mmss66661/crtc/README.md

# CRTC_CAR_DEMO

基于 **STM32F103C8T6** 的 PS2 手柄遥控小车，参加**重庆大学机器人训练大赛 CRTC2026**。
HAL 库 + CMake/Ninja 构建，C/C++ 混合编程。

PS2 手柄经软件模拟 SPI 时序读入摇杆与按键，主循环按麦轮逆运动学解算后驱动 4 路电机 PWM，实现前进、后退、左右横移与原地旋转；手柄「×」键切换 PB9 上的舵机角度。

---

## 演示视频

两段实拍记录：PS2 手柄遥控下底盘的起动、转向与停止。均为 **1920×1080 / 60 fps / H.264 + AAC**，满足手册 4.5 对清晰度的要求。

### 演示一：手柄遥控整机运动

<video src="docs/media/chassis-remote-01.mp4" controls width="720"></video>

> [`docs/media/chassis-remote-01.mp4`](docs/media/chassis-remote-01.mp4) —— 4.48 s / 12.2 MB

### 演示二：手柄遥控连续行驶

<video src="docs/media/chassis-remote-02.mp4" controls width="720"></video>

> [`docs/media/chassis-remote-02.mp4`](docs/media/chassis-remote-02.mp4) —— 10.45 s / 26.8 MB

> GitHub 会过滤 README 中的 `<video>` 标签，网页端请点击上方链接播放；VS Code / Typora 等本地预览可内联播放。

四轮电机开环 PWM 的单独演示见 [`docs/media/chassis-motion.mp4`](docs/media/chassis-motion.mp4)，硬件设计稿与实物见 [`docs/硬件开发记录.md`](docs/硬件开发记录.md)。

---

## 仓库结构

```
.
├── README.md                     本文件：项目概览与开发指引
├── docs/                         参赛文档（按 CRTC2026 手册 4.3 规范存放）
│   ├── README.md                 文档索引 + 中期考核指标完成情况
│   ├── 01-整体方案与硬件设计.md
│   ├── 02-底盘运动.md            麦轮解算与遥控，含演示视频
│   ├── 03-PS2手柄遥控.md         协议帧、bit-bang 时序、掉线保护
│   ├── 04-开发日志与问题排查.md
│   ├── 05-舵机机构.md            PB9 舵机与按键切换
│   ├── 06~11                    电控 / 硬件 / 机械三组「学习记录 + 进度记录」
│   └── media/                    演示视频与硬件图片
├── Chassis/                      底盘层：电机控制 + 麦轮解算 + 板级初始化
├── PS2/                          PS2 手柄驱动（GPIO 模拟 SPI 时序）
├── Servo/                        舵机控制（PB9 / TIM4_CH4，50 Hz PWM）
├── Core/                         CubeMX 生成的 HAL 初始化
├── Drivers/                      STM32 HAL / CMSIS
├── cmake/                        构建配置
├── CMakeLists.txt                构建入口
└── flash.bat                     一键烧录脚本（ST-LINK）
```

> 详细设计说明与技术决策从 `docs/README.md` 的索引进入。

---

## 硬件

| 项目 | 参数 |
| --- | --- |
| MCU | STM32F103C8T6（Cortex-M3，64 KB Flash / 20 KB SRAM） |
| 系统时钟 | HSE 8 MHz × PLL9 = **72 MHz**（AHB 72 / APB1 36 / APB2 72） |
| 电机驱动 | TIM1 CH1~CH4 输出 PWM，20 kHz（72 MHz / 3600），IN2 与 STBY 由 GPIO 控制 |
| 手柄接口 | PS2 接收器，PA4~PA7 软件模拟时序（已接入遥控） |
| 舵机 | PB9（TIM4_CH4），50 Hz，脉宽 500~2500 μs |
| 调试接口 | SWD（PA13 / PA14） |

| MCU 引脚 | 网络名 | 功能 |
| --- | --- | --- |
| PA8 / PB12 | FL_IN1 / FL_IN2 | 左前电机（CH1 + GPIO） |
| PA9 / PB13 | FR_IN1 / FR_IN2 | 右前电机（CH2 + GPIO） |
| PA10 / PB14 | BL_IN1 / BL_IN2 | 左后电机（CH3 + GPIO） |
| PA11 / PB15 | BR_IN1 / BR_IN2 | 右后电机（CH4 + GPIO） |
| PB0 / PB1 | STBY1 / STBY2 | 前级 / 后级驱动使能（高有效） |
| PB9 | SERVO | 舵机信号（TIM4_CH4，50 Hz / 500~2500 μs） |
| PA4~PA7 | DI / CMD / CS / CLK | PS2 接收器（软件模拟时序） |

> 板上 PB3 / PB4 / PB5 / PB6 为空脚，`MX_TIM2_Init` / `MX_TIM3_Init` / `MX_SPI1_Init` 已停用。

---

## 软件结构

```
Core/               STM32CubeMX 生成的 HAL 初始化（时钟、GPIO、中断）
Chassis/            底盘层（板级引脚初始化在此完成，不依赖 tim.c / spi.c）
  Inc/Chassis.h       Motor 类（PWM + 方向脚）+ ChassisCtrl（麦轮解算）
  Src/Chassis.cpp     TIM1 PWM 初始化、STBY 使能、麦轮逆运动学、等比缩放
PS2/                PS2 手柄驱动（GPIO 模拟 SPI 时序）
  Inc/PS2.h           PS2 类 + C 接口（PS2_Init / PS2_ReadRaw）
  Src/PS2.cpp         9 字节帧协议、bit-bang 时序、模拟模式握手、DWT 微秒延时
Servo/              舵机层
  Inc/Servo.h         角度接口（servo_set_angle / servo_toggle）
  Src/Servo.cpp       TIM4_CH4 50 Hz PWM、脉宽换算
cmake/              CubeMX 生成的 CMake 目标
```

### 控制流程

```
chassis_move(vx, vy, w) ──> ChassisCtrl::update_mecanum()
                                 │
        FL = vx - vy - w     FR = vx + vy + w
        BL = vx + vy - w     BR = vx - vy + w
                                 │
                          超量程时等比缩放
                                 │
                                 ▼
                          Motor::set_speed()
                                 │
             正转：IN2 = 0, CCR = |speed|   反转：IN2 = 1, CCR = |speed|
                                 │
                        TIM1 CHx ──> IN1 占空比
```

- `vx` 正为前进，`vy` 正为右移，`w` 正为逆时针自转；
- 速度限幅 ±3600（100% 占空比），**死区 ±28** 防止电机堵转啸叫；
- 超量程时按最大值等比压缩、方向不变，避免截断破坏四轮配比导致走斜；
- 保留原 `update(v, turn)` 差速接口作备用，底层 `Motor` 不变。

### 当前固件：PS2 手柄遥控

`Core/Src/main.c` 以 50 Hz 读手柄并驱动麦轮：

| 输入 | 动作 |
| --- | --- |
| 左摇杆 ↑ / ↓ | 前进 / 后退 |
| 左摇杆 ← / → | 左移 / 右移（横移） |
| 右摇杆 ← / → | 逆时针 / 顺时针原地旋转（半速） |
| **× 键（A）** | 舵机在 30° / 150° 之间切换（边沿触发） |

```c
#define JOY_CENTER     128
#define JOY_DEADZONE   12                    // 约 ±10% 死区
#define JOY_SCALE      (3600.0f / 128.0f)
#define W_SCALE        (1800.0f / 128.0f)    // 旋转降半速
#define CTRL_PERIOD_MS 20U                   // 50 Hz
#define PS2_LOST_LIMIT 5U

chassis_move(-(float)ly * JOY_SCALE, (float)lx * JOY_SCALE,
             -(float)rx * W_SCALE);
```

- 摇杆值 0~255、中位 128，偏移量乘 `JOY_SCALE` 映射到 ±3600；死区内归零，避免回中不准时自己爬；
- **掉线保护**：连续 5 次读不到合法帧即 `chassis_move(0,0,0)`，不会保持最后速度冲出去；
- 舵机按键做上升沿检测，按住只切换一次。

PS2 协议帧、bit-bang 时序与舵机时基见文档 [03](docs/03-PS2手柄遥控.md)、[05](docs/05-舵机机构.md)。

---

## 构建

依赖 [STM32CubeCLT](https://www.st.com/en/development-tools/stm32cubeclt.html)（含 arm-none-eabi-gcc、CMake、Ninja）。

```bash
export PATH="/e/STM32CubeCLT_1.18.0/GNU-tools-for-STM32/bin:/e/STM32CubeCLT_1.18.0/Ninja/bin:/e/STM32CubeCLT_1.18.0/CMake/bin:$PATH"

cmake -S . -B build/Debug -G Ninja \
      -DCMAKE_BUILD_TYPE=Debug \
      -DCMAKE_TOOLCHAIN_FILE=cmake/gcc-arm-none-eabi.cmake

cmake --build build/Debug
```

产物 `build/Debug/CRTC_CAR_DEMO.elf`，当前 RAM 占用 1832 B（8.95%）、FLASH 13276 B（20.26%）。

> 构建目录与工具链强绑定：若被 IDE 自带的 MinGW 配置过，删掉 `build/Debug` 重新 configure，不要修补缓存。

---

## 烧录

双击 `flash.bat`（调用 STM32CubeProgrammer CLI，自动校验并判定结果），或手动执行：

```bash
cd "E:/STM32CubeCLT_1.18.0/STM32CubeProgrammer/bin"
./STM32_Programmer_CLI.exe -c port=SWD mode=UR \
  -w "path/to/CRTC_CAR_DEMO.elf" -v -rst
```

**排障**：正常连接会打印 `Voltage : 3.2V` 左右；若显示 `0.00V` / `1.x V` 且报 `Unable to get core ID`，说明目标板未正常供电或 SWD 未共地，先查供电与 GND 导通（详见文档 [04](docs/04-开发日志与问题排查.md)）。

> **重要**：`MX_TIM2_Init` / `MX_TIM3_Init` / `MX_SPI1_Init` 已停用，电机与舵机初始化分别由 `chassis_init()` / `servo_init()` 完成。`CRTC_CAR_DEMO.ioc` 仍是旧配置，**不要用 CubeMX 重新生成代码**，否则会重新占用 PA6/PA7/PB0/PB1 并覆盖引脚修正。

---

## 已知问题

1. **方向待实测确认**：横移与旋转的正负号取决于麦轮辊子安装朝向，若与操作相反，只需对 `update_mecanum()` 中对应的 `vy` / `w` 取反。
2. **右侧电机 O1/O2 顺序存疑**：H2/H4 排针的 6/7 脚与左侧相反，1:1 排线会让右侧反转；确认后用 `Motor::set_reversed(true)` 一行处理。
3. **舵机供电**：舵机电源独立于 3.3 V 并与 MCU 共地，上电抖动多为供电不足。
4. **缺少看门狗**：主循环为 `HAL_Delay(20)` 的 50 Hz 软节拍，实际控速建议改为定时器中断。
5. **`.ioc` 技术债**：见上文「重要」提示。
