mmss66661/crtc/docs/README.md

# CRTC2026 参赛文档

本目录为重庆大学机器人训练大赛（CRTC2026）中期考核文档，按机器人设计进度的时间顺序组织。

> 队伍信息、实训分组、队长姓名等占位内容请提交前补全。

| 项目 | 内容 |
| --- | --- |
| 赛事 | 重庆大学机器人训练大赛 CRTC2026 |
| 机器人名称 | CRTC_CAR_DEMO |
| 主控 | STM32F103C8T6 |
| 组别 | 非新生组 |
| 实训战队 | RT凌龙战队 |
| 队伍名称 | 扬程战队 |

---

## 文档索引

| 序号 | 文档 | 内容 |
| --- | --- | --- |
| 01 | [整体方案与硬件设计](01-整体方案与硬件设计.md) | 整体方案 / 硬件构成 / 引脚与接口 |
| 02 | [底盘运动](02-底盘运动.md) | 电机运动、麦轮解算与遥控映射 |
| 03 | [PS2 手柄遥控](03-PS2手柄遥控.md) | 协议帧、bit-bang 时序、握手与掉线保护 |
| 04 | [开发日志与问题排查](04-开发日志与问题排查.md) | 分阶段演进与关键问题 |
| 05 | [舵机机构](05-舵机机构.md) | PB9 舵机、50 Hz 时基与按键切换 |
| 06 | [电控学习记录](./电控学习记录.md) | 电控学习笔记 |
| 07 | [电控开发进度](./电控开发进度.md) | 电控进度与验证 |
| 08 | [硬件学习记录](./硬件学习记录.md) | 嘉立创全流程学习笔记 |
| 09 | [硬件开发记录](./硬件开发记录.md) | 主控板设计、自绘两级降压与调试 |
| 10 | [机械学习记录](./机械学习记录.md) | Fusion 360 学习笔记 |
| 11 | [机械开发进度](./机械开发进度.md) | 叉车机构与齿条传动的设计进度 |

**01~05 按功能板块**写「做成了什么」，**06~11 按专业分册**写「怎么学会的、进行到哪一步」；每个专业分册都是「学习记录 + 进度记录」成对出现。

| 专业 | 工具 / 关键词 | 当前阶段 |
| --- | --- | --- |
| 电控 | STM32 HAL、PID、麦轮解算、ROS2 + MoveIt | 麦轮解算与手柄遥控已实现待实测；速度闭环仅在台架 |
| 硬件 | 嘉立创 EDA / 立创商城 / 打样；引脚、VCC/GND、LDO、DCDC、DRV8833、走线 | 主控板已打样并跑通四轮驱动 |
| 机械 | Fusion 360；草图、几何约束、拉伸、扫掠、齿条、叉车、三维建模 | 结构件完成；叉车升降机构建模中，未装车 |

---

## 跨分册待确认项

以下**分册之间**存在口径差异或依赖，提交前需统一：

| 编号 | 事项 | 相关分册 | 说明 |
| --- | --- | --- | --- |
| X1 | PID 闭环是台架还是整车 | 电控 06 / 02 | 整车 `Chassis/` 仍是开环 PWM + ±28 死区，应表述为「台架已验证、整车未集成」 |
| X2 | 横移与旋转方向是否与操作一致 | 电控 06 / 01、02 | 麦轮逆运动学已实现并接入主循环，方向取决于辊子安装朝向，待实测确认符号 |
| X3 | 板面 `+12V` 丝印与 2S 电池不匹配 | 硬件 09 / 01 | 实物电池组标称 12 V，而方案写 2 节 18650（7.4 V），需确认实际供电与升压环节 |
| X4 | 降压电路是板载还是外挂模块 | 硬件 09 / 01 | 已按 V1.0 原理图确认为**板载自绘两级降压**（LM2575S-5.0 → AMS1117-ADJ），01 需同步改写 |
| X5 | 升降电机驱动通道未分配 | 机械 11 / 电控、硬件 | TIM1 四通道已占满、TIM4 给了舵机，机械做完会装不上电 |

---

## 中期考核指标完成情况

按手册 4.1.2《考核指标一览》逐项自查，**已完成项均已附演示材料**。

| 功能指标 | 状态 | 证明材料 |
| --- | --- | --- |
| 外形展示 | ⬜ 未提交 | 待拍摄整车绕车一周视频 |
| 电机运动（单一 / 全部） | ✅ 已完成 | `media/chassis-motion.mp4`，四轮同时同向转动 |
| 舵机运动（单一） | 🟡 代码就绪待实测 | PB9 舵机 + 手柄 × 键切换，见文档 [05](05-舵机机构.md) |
| 舵机运动（多项） | ⬜ 不适用 | 仅装配 1 个舵机 |
| 底盘运动（单一 / 全部） | 🟡 已录实拍待确认方向 | 手柄遥控 + 麦轮全向移动，见 `media/chassis-remote-01/02.mp4` |
| 尺寸规范 | ⬜ 未提交 | 待直尺实测，见文档 [11](./机械开发进度.md) |
| 方块携带（单一 / 多项） | ⬜ 未实现 | 叉车 + 齿条方案建模中，见文档 [11](./机械开发进度.md) |
| 结构稳定性 | ⬜ 未提交 | 待做 180 mm 自由落体测试，见文档 [11](./机械开发进度.md) |
| 规划 / 现有采购单 | ⬜ 未提交 | 见文档 01 成本小节 |

> 手册允许中期测评队伍不产出实物演示；未实现的功能指标不提交对应演示材料。

### 视频材料

| 文件 | 参数 | 说明 |
| --- | --- | --- |
| `media/chassis-motion.mp4` | 1280×720 / 30 fps / 9.03 s / 2.5 MB | 四轮电机运动，⚠️ 720p 低于手册 4.5 要求 |
| `media/chassis-remote-01.mp4` | 1920×1080 / 60 fps / 4.48 s / 12.2 MB | PS2 手柄遥控实拍 |
| `media/chassis-remote-02.mp4` | 1920×1080 / 60 fps / 10.45 s / 26.8 MB | PS2 手柄遥控实拍 |

提交时按「实训战队名称 + 队伍名称 + 队长姓名」命名并打包为 .zip。

---

## 关于开源项目的说明

本项目**未使用任何第三方开源机器人项目或开源控制代码**。外部资源仅限 STM32Cube HAL 库（BSD-3-Clause）、CMSIS Core/Device 头文件（Apache-2.0 / BSD-3-Clause）与 STM32CubeMX 生成的工程骨架，许可证原文随源码保留在 `Drivers/` 目录下（`LICENSE.txt`）。

底盘麦轮解算、电机控制类（`Chassis/`）、PS2 协议帧与 bit-bang 时序（`PS2/`）、舵机控制（`Servo/`）均为本队自行编写。
