mmss66661/crtc/docs/电控学习记录.md

# 电控学习记录

| 项目 | 内容 |
| --- | --- |
| author | cmz |
| description | 电控学习文档 |

按时间顺序记录学习笔记，进度与验证见《[电控开发进度](./电控开发进度.md)》。

## 9.25-10.1 STM32 HAL 库学习（重点：SPI 通信、GPIO 与 PWM 控制）

### 理解:
- SPI 作为有时序的全双工通信，很适合在 500 Hz 频率下作为机器人遥控的通信协议
- PWM 由于其脉冲方波特性，作为信号输入经放大器控制电机
- GPIO 由于其简洁性和通用性，适合在程序运行期间控制引脚电气属性，从而实现通用控制，如软件 SPI 等

## 10.1-10.5 学习经典控制理论(PID)

### 理解：
- PID控制器由三种控制耦合而成，P`(比例控制)`，I`(积分控制)`,D`(微分控制)`
- 对于P控制，其有低通滤波特性，根据当前目标值和实际值误差乘上比例系数,作为PID控制的主要控制输入
- 对于I控制，通常用于解决系统静态误差，其表现为随着时间增大而控制力度增大，但是需要考虑其在超大阶跃下超调影响，通常使用积分限幅和积分分离减少影响。
- 对于D控制器，我认为其作为PID控制中的阻尼作用约束P控制，所以PD控制器通常作为位置控制，但是我仍然不理解其在时域下的高频震荡原理

## 10.6-10.13 学习运动学逆解(麦轮解算)

### 理解：

- 在经典运动学中，运动学中的线量（线位移、线速度、线加速度）和角量（角位移、角速度、角加速度）可以合成也可以分解，我觉得正解(FK)和逆解(IK),是由此得来
- 底盘速度分解出$V_x$，$V_y$和$\omega$,轮子线速度分解出$V_x$和$V_y$，四个麦轮的线速度合并成为底盘的速度，麦轮底盘解算公式从此得来

## 10.13-10.18 现代控制理论(六轴机械臂运动学逆解)

### 平台：使用ROS2+Moveit库进行解算

### 六轴机械臂正解原理

#### DH（Denavit–Hartenberg 参数）

DH参数是一套连杆坐标系参数，用于表示上一个关节到下一个关节的几何参数，内容如下：

| 沿z轴转动角度 | 沿z轴平动距离 | 沿x轴平动距离 | 沿x轴转动角度 |
| --- | --- | --- | --- |
| $\theta_i$ | $d_i$ | $a_i$ | $\alpha_i$ |

#### 相邻连杆变换

$$
^{i-t}T_{i}  = Rot_z(\theta_i) \times Trans_z(d_i) \times Trans_x(a_i) \times Rot_x(\alpha_i)
$$

**矩阵形式**

$$
{}^{i-1}T_i = 
\begin{bmatrix}
\cos\theta_i & -\sin\theta_i\cos\alpha_i & \sin\theta_i\sin\alpha_i & a_i\cos\theta_i \\
\sin\theta_i & \cos\theta_i\cos\alpha_i & -\cos\theta_i\sin\alpha_i & a_i\sin\theta_i \\
0 & \sin\alpha_i & \cos\alpha_i & d_i \\
0 & 0 & 0 & 1 
\end{bmatrix}
$$

#### ok,那么进入正解

$^{0}T_n = ^0T_1 \cdot ^1T_2 \cdots$

这是最终转换矩阵

同时我们知道

$$
^0T_n=\begin{bmatrix}
R & p \\
0 & 1
\end{bmatrix}
$$

不难得出位姿

#### 那么，逆解：
$x = f{q}$

$q = f^{-1}(x)$

由雅可比矩阵：

$\partial{x} = J(q) \partial{q}$
