mmss66661/crtc/(commit log)

2026-10-17 Initial commit: STM32F103C8T6 PS2 遥控小车
    - CubeMX 生成的 HAL 工程（CMake + Ninja）
    - PS2 手柄 SPI1 驱动（重映射 PB3/PB4/PB5，CS=PB6）
    - 底盘差速解算与 TIM2/TIM3 八路 PWM 电机控制
    - README 与 flash.bat 一键烧录脚本
2026-10-17 调试模式：写死持续前进，并修复电机数组越界
    - main.c 移除 PS2 遥控逻辑，改为 update(FORWARD_SPEED, 0) 持续前进
    - 新增 FORWARD_SPEED 宏（1500 ≈ 42% 占空比），便于调参
    - 修复 ChassisCtrl 构造中 _m[4] 越界写入，改为 _m[3]，
    避免 _m[3] 保持空指针导致 set_speed() 解引用崩溃
    - README 同步更新：调试模式说明、资源占用、已知问题
    [Chassis.cpp, main.c]
2026-10-17 按 PCB 原理图重写电机驱动层：TIM1 PWM + 方向/使能 GPIO
    原固件引脚与实物板完全对不上：TIM2(PA0~PA3)、TIM3(PA6/PA7/PB0/PB1)、
    SPI1 重映射(PB3~PB6) 在板上分别是空脚、PS2 的 CS/CLK、STBY。
    - 电机 IN1 改用 TIM1 CH1~CH4（PA8/PA9/PA10/PA11），20kHz PWM
    - 电机 IN2 改用 PB12~PB15 推挽输出，决定正反转
    - STBY1/STBY2 改用 PB0/PB1，上电拉高使能驱动
    - Motor 类重构为「PWM 通道 + 方向脚」，新增 set_reversed() 便于软件翻转单侧转向
    - 修正左右轮分配：FL/BL 走左侧，FR/BR 走右侧
    - main.c 停用 MX_TIM2/MX_TIM3/MX_SPI1_Init，避免占用 PA6/PA7/PB0/PB1
    - README 同步引脚表、控制流程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
    [Chassis.cpp, Chassis.h, main.c]
2026-10-17 调试模式转速拉满：FORWARD_SPEED 1500 -> 3600（100% 占空比）
2026-10-17 按 CRTC2026 手册 4.3 规范重构文档结构，加入底盘运动演示视频
    手册要求：文档以 markdown 提交、全部置于仓库根目录 docs/ 下、
    按时间顺序组织、以「功能（H2）+ 功能描述与开发历程」为板块。
    - 新增 docs/README.md：文档索引、中期考核指标完成情况自查表、开源组件声明
    - 新增 docs/01-整体方案与硬件设计.md：整体方案、主控时钟、驱动引脚、电源与接口
    - 新增 docs/02-底盘运动.md：电机运动（全部）、差速解算、符号-幅值控制、踩坑记录
    - 新增 docs/03-PS2手柄遥控.md：9 字节帧协议、时序、引脚冲突与 bit-bang 方案
    - 新增 docs/04-开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
2026-10-18 docs: 补全电控开发进度文档骨架
    按四阶段（HAL 入门 / PID / 麦轮解算 / 六轴臂逆解）补齐目标、
    学习内容、关键理解、实做验证与遗留问题，并标注与 01/02 文档
    在 PID 落地与麦轮装车两处的口径差异。
2026-10-18 docs: 新增硬件学习记录与硬件开发记录
    围绕嘉立创全流程、引脚规划、VCC/GND 处理、LDO 与 DCDC 选型、
    走线载流估算、DRV8833 外围与散热，补齐硬件侧学习记录与开发记录。
2026-10-18 docs: 新增机械学习记录与机械开发进度
    围绕 Fusion 360 参数化建模链（草图、几何约束、拉伸、扫掠），
    以及叉车货叉与齿条升降机构的设计选型、几何关系、装配与干涉检查，
    补齐机械侧学习记录与进度文档。
2026-10-18 docs: README 补充分册概要
    新增「分册概要」小节：三专业的学习记录/进度记录配对、各专业结论
    速览、跨分册待确认项 X1~X5；中期考核表补充到机械文档的引用。
    同时纳入 README 已有的队伍信息填写与 05/06 索引、电控学习记录。
2026-10-18 改为麦轮运动学，主循环做前后左右四方向固定轮播
    确认车体装配的是麦克纳姆轮，原差速解算无法横移。
    - ChassisCtrl 新增 update_mecanum(vx, vy, w)，按 X 型辊子布局做逆运动学：
    FL=vx-vy-w, FR=vx+vy+w, BL=vx+vy-w, BR=vx-vy+w
    - 合成速度超量程时等比缩放，保持四轮比例与合速度方向
    - 新增 C 接口 chassis_move()，保留原 update() 差速解算作为备用
    - main.c 主循环改为 前→后→左→右 固定序列（写死非随机），
    每个方向 3 秒，动作之间停车间隔 5 秒，一轮 32 秒
    - 文档同步：README、01 方案、02 底盘运动、04 开发日志中的差速表述改为麦轮
2026-10-18 接入 PS2 手柄遥控（GPIO 模拟 SPI 时序）
    板上 PS2 走 PA4~PA7，顺序与 SPI1 硬件功能不兼容，改用 bit-bang。
    - PS2 驱动重写：删除 HAL_SPI 依赖，CLK 空闲高、LSB 先行、
    半周期 3us、字节间隔 30us、CS 全程拉低，DI 上拉输入
    - 上电 300ms 后发送三段命令让手柄进入模拟模式
    - read() 校验模式字节 0x41/0x73/0x79，非法返回 false，
    修复原实现恒返回 true、online_ 从未赋值的缺陷
    - main.c 改为 50Hz 手柄控制：左摇杆平移（前后/横移）、
    右摇杆 X 旋转，±12 死区，旋转降半速，
    连续 5 次读失败则停车
    - 文档同步：README、02 底盘运动、03 PS2 遥控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
    [PS2.cpp, PS2.h, main.c]
2026-10-18 新增 PB9 舵机，手柄 × 键切换角度
    - 新增 Servo 模块：TIM4_CH4 (PB9)，PSC=71/ARR=19999 -> 1MHz、20ms、50Hz，
    CCR 直接为脉宽微秒数（500~2500 对应 0~180°）
    - 上电 90° 中位，按键在 30°/150° 之间往复，避开机械极限
    - main.c 用按键上升沿触发，避免 50Hz 下按住被读成连续翻转
    - CMakeLists 注册 Servo 源文件与头文件路径
    - 文档：新增 docs/05-舵机机构.md，README/01/04 同步引脚与功能说明
2026-10-18 docs: README 嵌入 PS2 手柄遥控演示视频
    新增 docs/media/chassis-remote-01/02.mp4（1920x1080 / 60 fps），并在 README 增加「演示视频」章节内联展示。
2026-10-18 docs: 硬件开发记录加入原理图、PCB 与装车实物图
    新增 docs/media/hardware-* 三张图片，并在硬件开发记录中增加「硬件进度：设计稿与实物」章节。
2026-10-18 docs: 硬件开发记录突出自绘两级降压电源电路
    补充 LM2575S-5.0（12V→5V Buck）与 AMS1117-ADJ（5V→3.3V LDO）的选型、取值、布局要求与四项打样前复核项；电源树与档位表按 V1.0 原理图命名；同步 X4 口径。
2026-10-18 docs: 精简文档描述，去除重复与冗余表述
    总计 1955 → 1459 行。删除跨文档重复的接口表、齿条公式、PID/麦轮口径说明与问题清单，改为交叉引用；压缩论证性长句与自我点评式段落，保留数据、表格、结论与待确认项。同步修正电控学习记录缺失的标题与若干错字。
2026-10-18 编辑中期考核文档
